Edgar7805/cosimetro-digital/placa de control.jpg

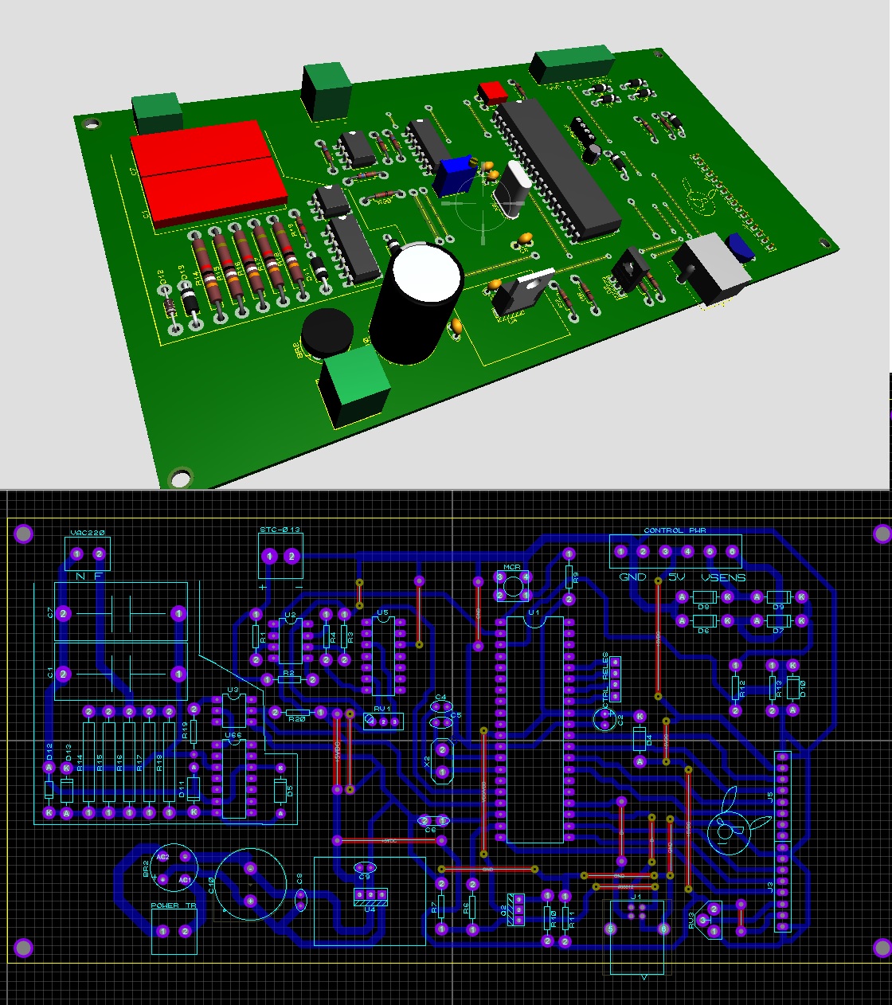
placa de control.jpg
