Edgar7805/cosimetro-digital/README.md

# cosimetro-digital
medidor del factor de potencia con pic
