Edgar7805/cosimetro-digital/interfaz/interfaz/Resources/Captura de pantalla_20221204_174604.png

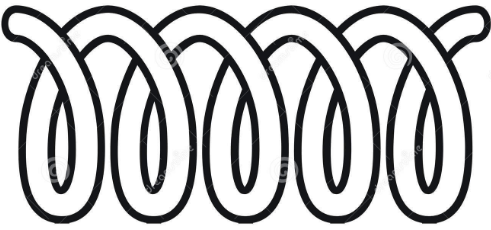
interfaz/interfaz/Resources/Captura de pantalla_20221204_174604.png
