Edgar7805/cosimetro-digital/placa de potencia.png

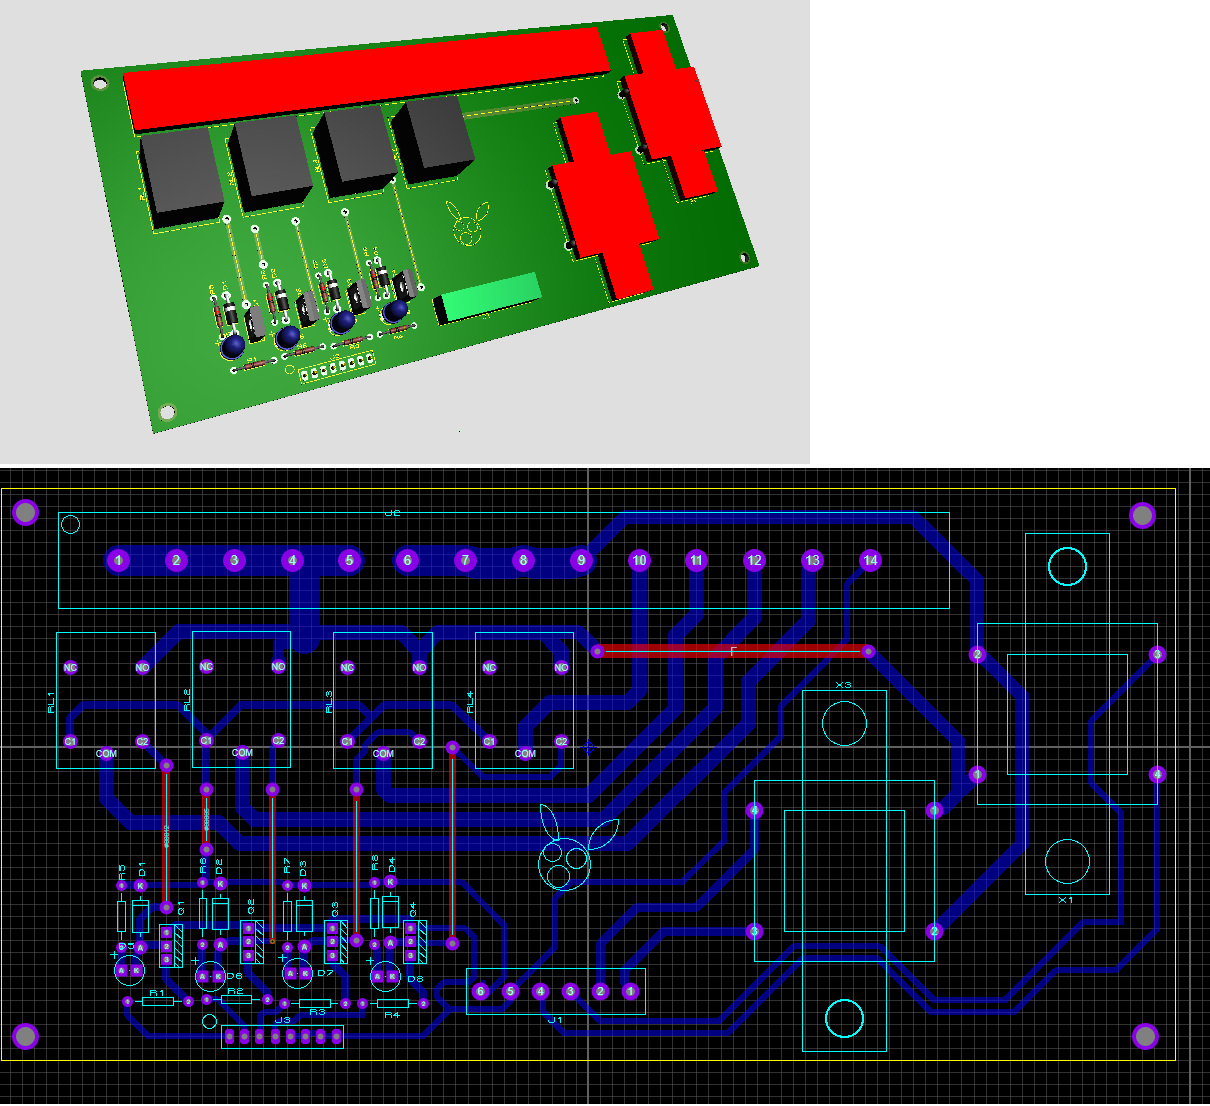
placa de potencia.png
