Edgar7805/cosimetro-digital/(list of files, drawings)

Other design files:
esquematicos/filtrofilna.pdsprj
esquematicos/FP-DEFINITIVE-EDITION.pdsprj
esquematicos/placa de potencia final.pdsprj
