Edgar7805/cosimetro-digital/(commit log)

2024-01-06 esquemáticos en proteus 8
    [FP-DEFINITIVE-EDITION.pdsprj, filtrofilna.pdsprj, placa de potencia final.pdsprj]
2024-01-06 capturas de de squematicos
    placa de potencia y placa de control
2024-01-06 presentación de proyecto
    ppt de presentación final e informe final
